yJulian/gate-link/pcb/GateLinkMaster.kicad_sch

## KiCad design pcb/GateLinkMaster.kicad_sch (2026-10-08)

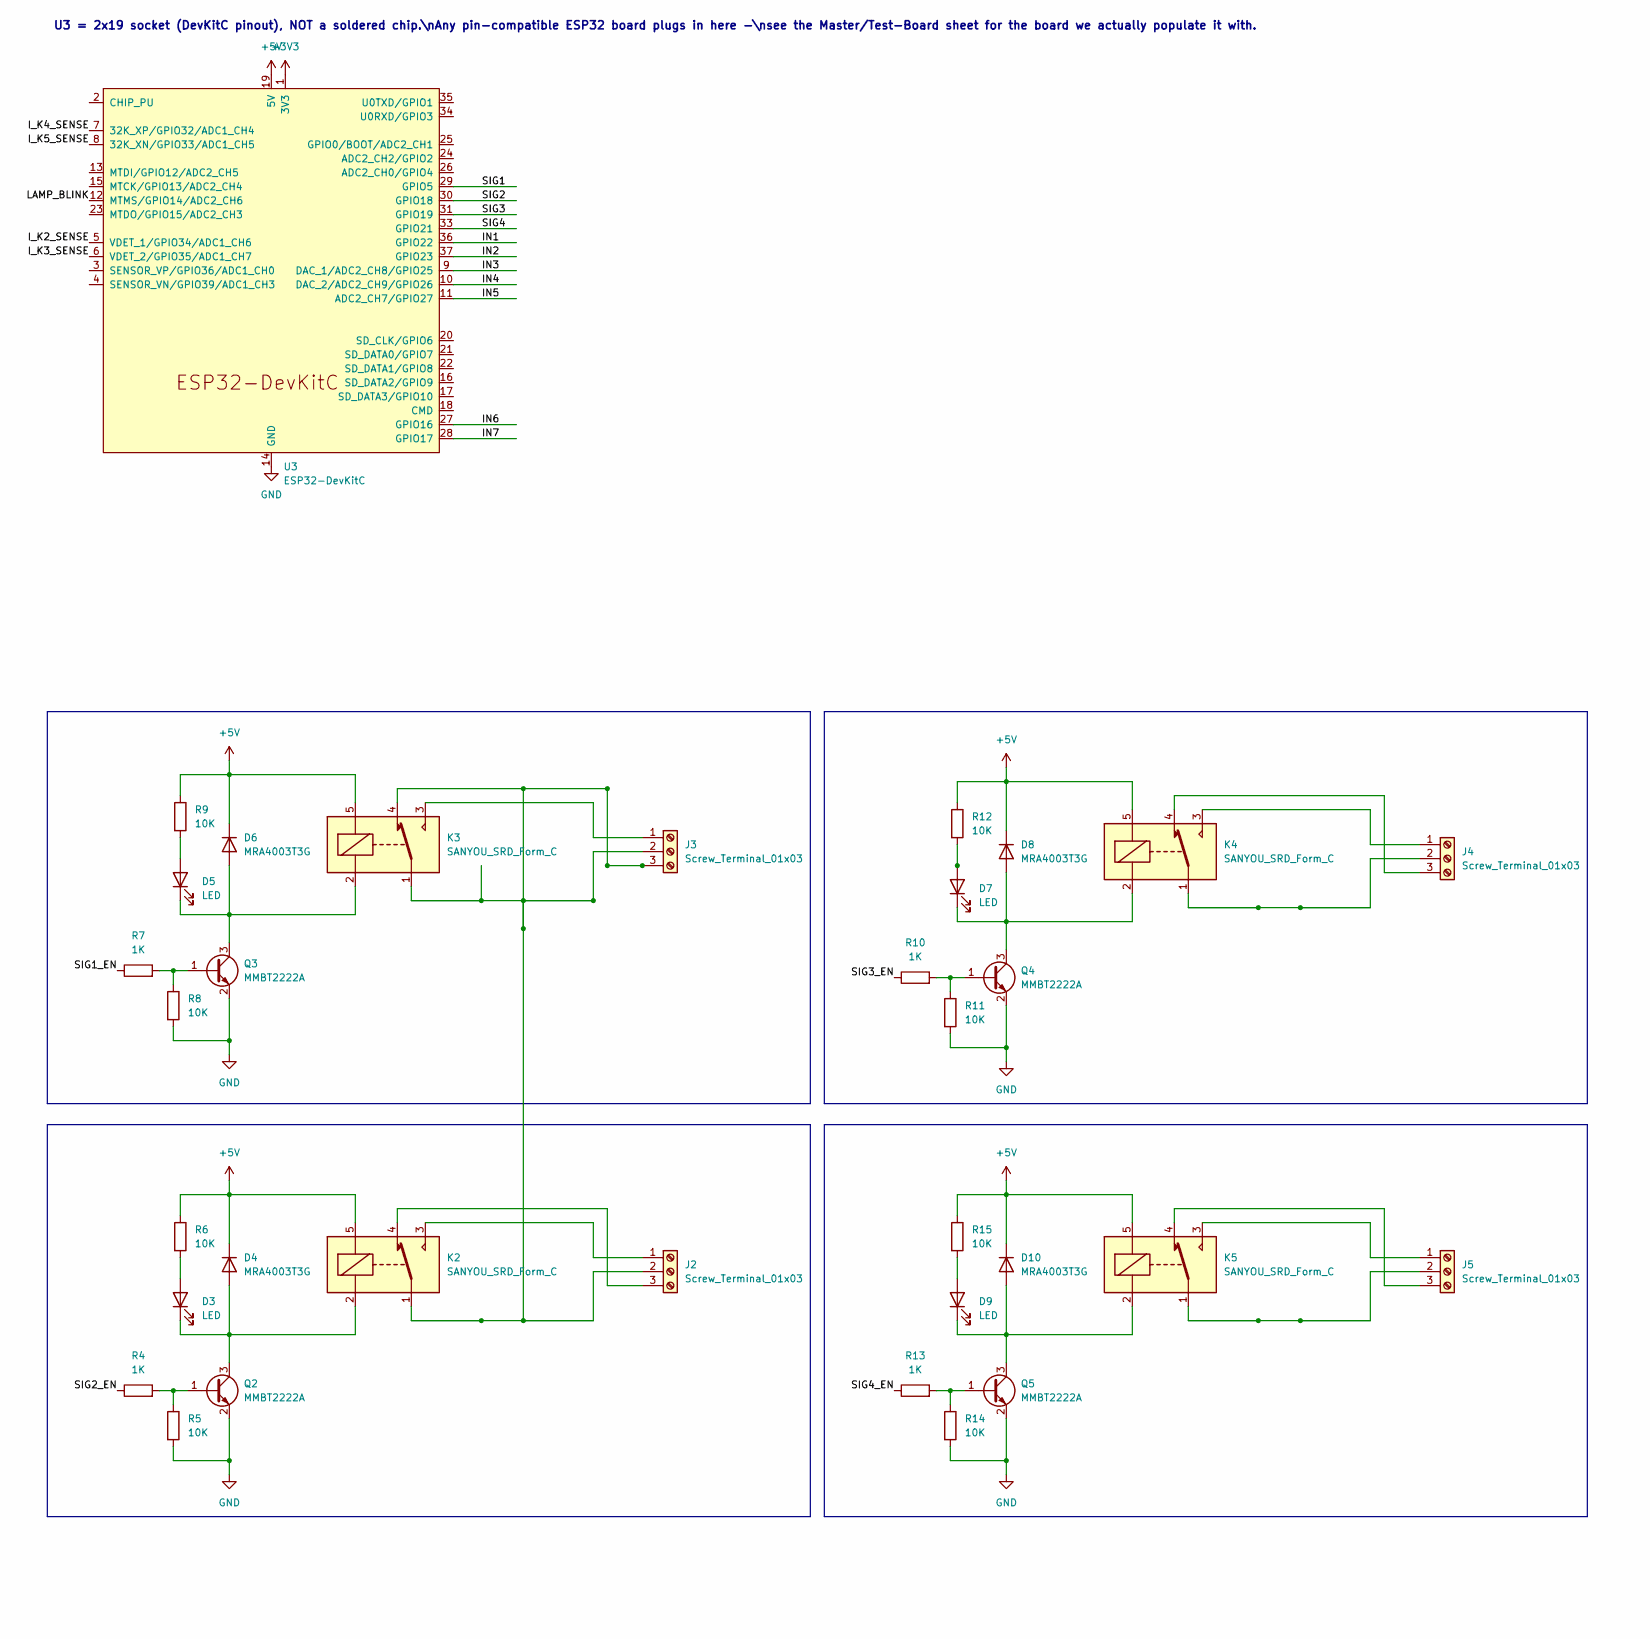
[picture p1: schematic GateLinkMaster.kicad_sch, part in row 1, column 1]

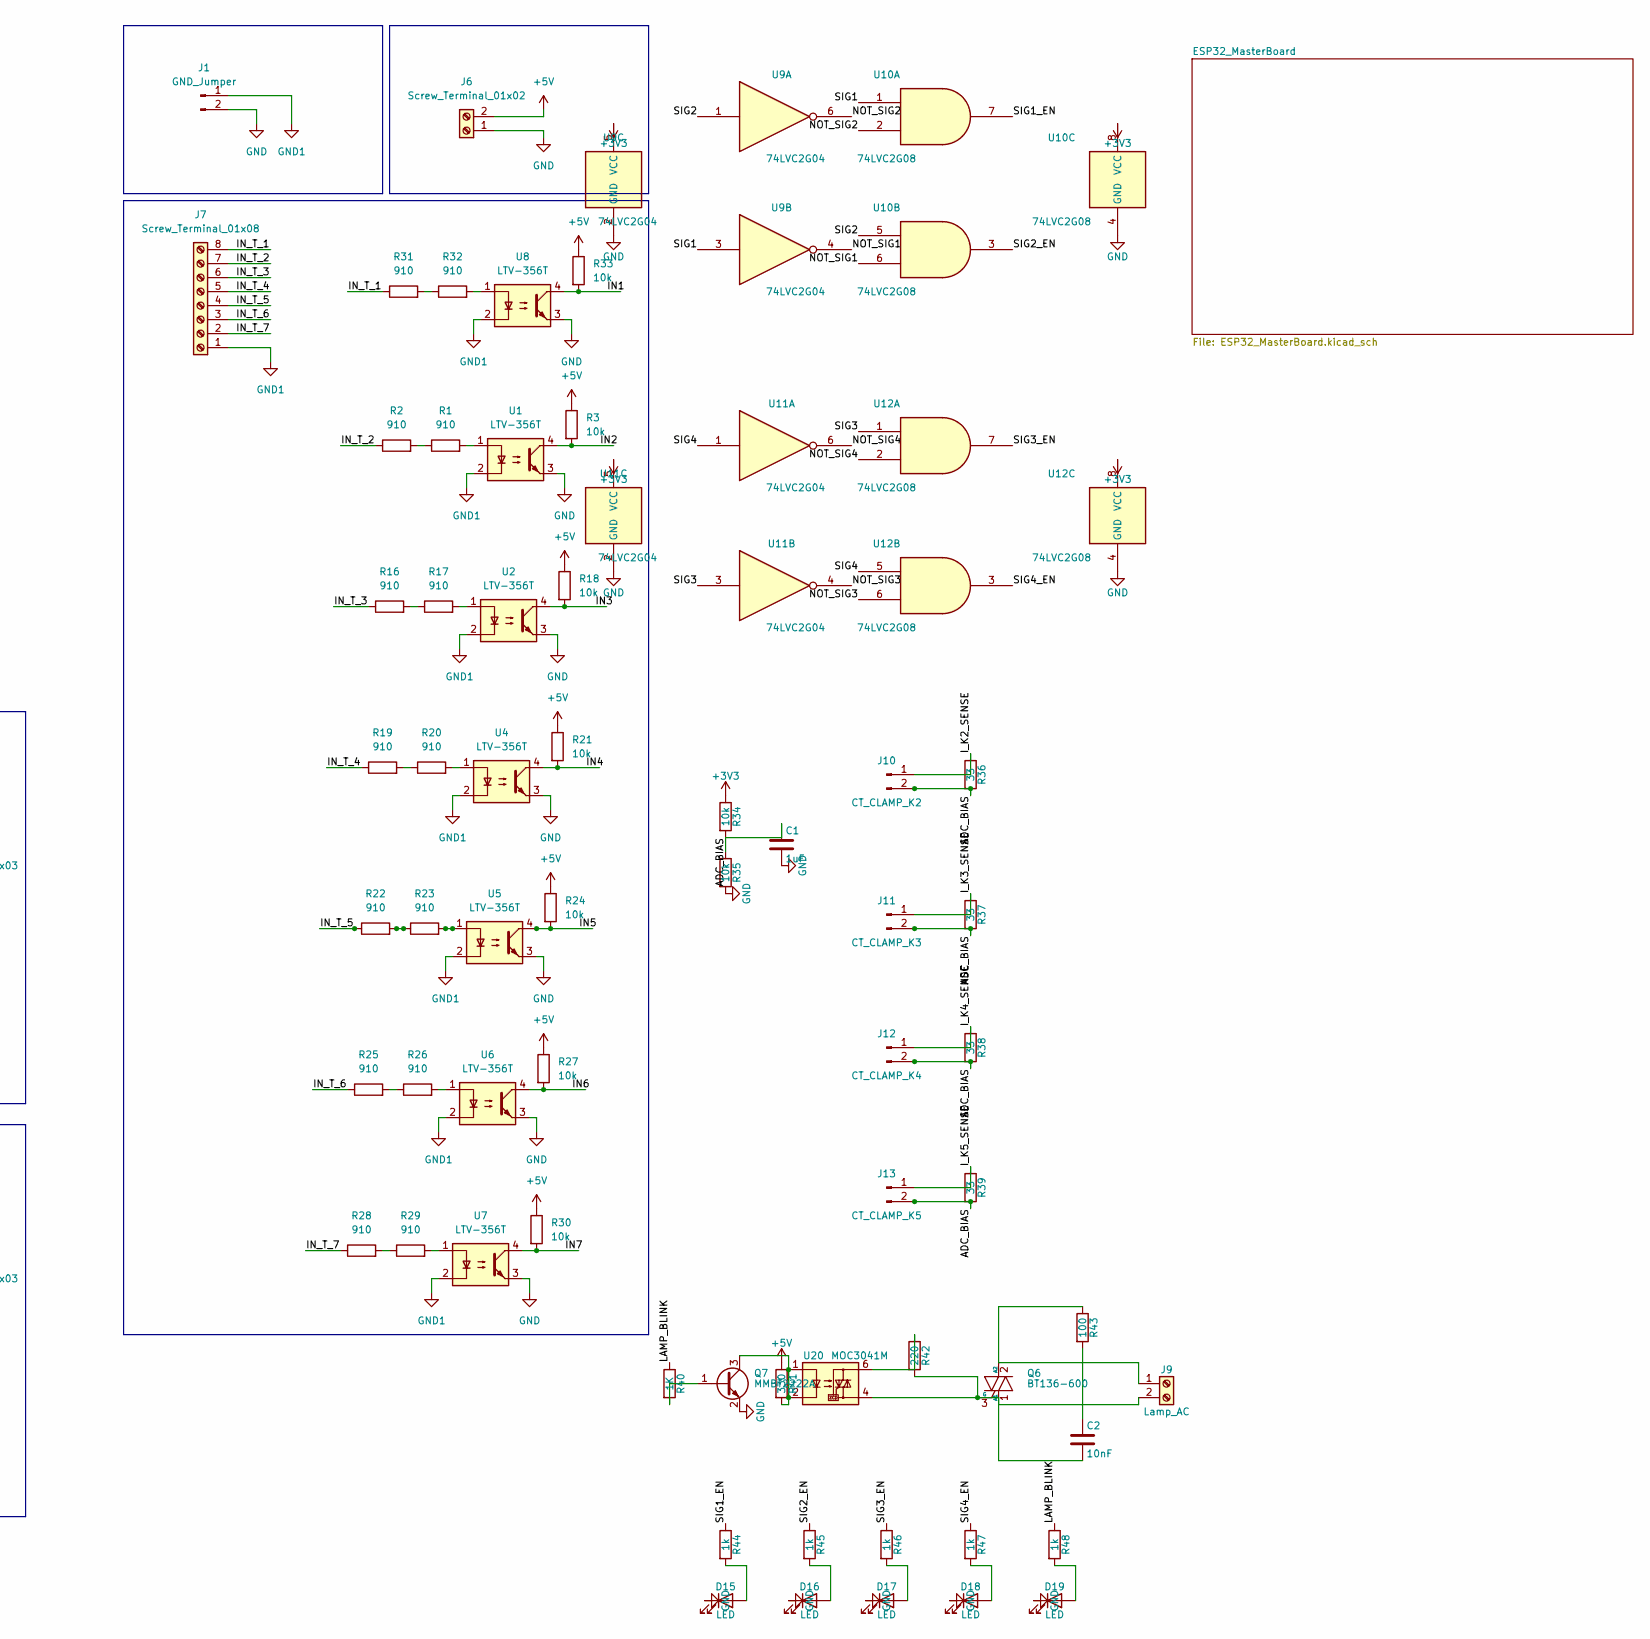
[picture p2: schematic GateLinkMaster.kicad_sch, part in row 1, column 2]

Parts:
C1: 1uF; C_0603_1608Metric
C2: 10nF; C_0603_1608Metric
D3, D5, D7, D9, D15, D16, D17, D18, D19: LED; LED_0603_1608Metric
D4, D6, D8, D10: MRA4003T3G; D_SMA
J1: GND_Jumper; PinHeader_1x02_P2.54mm_Vertical
J2, J3, J4, J5: Screw_Terminal_01x03; TerminalBlock_MaiXu_MX126-5.0-03P_1x03_P5.00mm
J6: Screw_Terminal_01x02; TerminalBlock_MaiXu_MX126-5.0-02P_1x02_P5.00mm
J7: Screw_Terminal_01x08; TerminalBlock_WAGO_236-108_1x08_P5.00mm_45Degree
J9: Lamp_AC; TerminalBlock_MaiXu_MX126-5.0-02P_1x02_P5.00mm
J10: CT_CLAMP_K2; PinHeader_1x02_P2.54mm_Vertical
J11: CT_CLAMP_K3; PinHeader_1x02_P2.54mm_Vertical
J12: CT_CLAMP_K4; PinHeader_1x02_P2.54mm_Vertical
J13: CT_CLAMP_K5; PinHeader_1x02_P2.54mm_Vertical
K2, K3, K4, K5: SANYOU_SRD_Form_C; Relay_SPDT_SANYOU_SRD_Series_Form_C
Q2, Q3, Q4, Q5, Q7: MMBT2222A; SOT-23
Q6: BT136-600; TO-220-3_Vertical
R1, R2, R16, R17, R19, R20, R22, R23, R25, R26, R28, R29, R31, R32: 910; R_0805_2012Metric
R3, R18, R21, R24, R27, R30, R33: 10k; R_0805_2012Metric
R4, R7, R10, R13, R40: 1K; R_0603_1608Metric
R5, R6, R8, R9, R11, R12, R14, R15: 10K; R_0603_1608Metric
R34, R35: 10k; R_0603_1608Metric
R36, R37, R38, R39: 33; R_0603_1608Metric
R41: 330; R_0603_1608Metric
R42: 220; R_0603_1608Metric
R43: 100; R_0805_2012Metric
R44, R45, R46, R47, R48: 1k; R_0603_1608Metric
U1, U2, U4, U5, U6, U7, U8: LTV-356T; SO-4_4.4x3.6mm_P2.54mm
U3: ESP32-DevKitC; ESP32-DevKitC-Local
U9, U11: 74LVC2G04; SOT-23-6
U10, U12: 74LVC2G08; SOT-23-8
U20: MOC3041M; DIP-6_W7.62mm

Connections:
+3V3: R34.1, U3.1 (3V3), U9.5 (VCC), U10.8 (VCC), U11.5 (VCC), U12.8 (VCC)
+5V: D4.1 (K), D6.1 (K), D8.1 (K), D10.1 (K), J6.2, K2.5, K3.5, K4.5, K5.5, R3.1, R6.1, R9.1, R12.1, R15.1, R18.1, R21.1, R24.1, R27.1, R30.1, R33.1, R41.1, U3.19 (5V)
ADC_BIAS: C1.1, J10.2, J11.2, J12.2, J13.2, R34.2, R35.1, R36.2, R37.2, R38.2, R39.2
GND: C1.2, D15.1 (K), D16.1 (K), D17.1 (K), D18.1 (K), D19.1 (K), J1.2, J6.1, Q2.2 (E), Q3.2 (E), Q4.2 (E), Q5.2 (E), Q7.2 (E), R5.2, R8.2, R11.2, R14.2, R35.2, U1.3, U2.3, U3.14 (GND), U3.32 (GND), U3.38 (GND), U4.3, U5.3, U6.3, U7.3, U8.3, U9.2 (GND), U10.4 (GND), U11.2 (GND), U12.4 (GND)
GND1: J1.1, J7.1, U1.2, U2.2, U4.2, U5.2, U6.2, U7.2, U8.2
IN1: R33.2, U3.36 (GPIO22), U8.4
IN2: R3.2, U1.4, U3.37 (GPIO23)
IN3: R18.2, U2.4, U3.9 (DAC_1/ADC2_CH8/GPIO25)
IN4: R21.2, U3.10 (DAC_2/ADC2_CH9/GPIO26), U4.4
IN5: R24.2, U3.11 (ADC2_CH7/GPIO27), U5.4
IN6: R27.2, U3.27 (GPIO16), U6.4
IN7: R30.2, U3.28 (GPIO17), U7.4
IN_T_1: J7.8, R31.1
IN_T_2: J7.7, R2.1
IN_T_3: J7.6, R16.1
IN_T_4: J7.5, R19.1
IN_T_5: J7.4, R22.1
IN_T_6: J7.3, R25.1
IN_T_7: J7.2, R28.1
I_K2_SENSE: J10.1, R36.1, U3.5 (VDET_1/GPIO34/ADC1_CH6)
I_K3_SENSE: J11.1, R37.1, U3.6 (VDET_2/GPIO35/ADC1_CH7)
I_K4_SENSE: J12.1, R38.1, U3.7 (32K_XP/GPIO32/ADC1_CH4)
I_K5_SENSE: J13.1, R39.1, U3.8 (32K_XN/GPIO33/ADC1_CH5)
LAMP_BLINK: R40.1, R48.1, U3.12 (MTMS/GPIO14/ADC2_CH6)
NOT_SIG1: U9.4, U10.6
NOT_SIG2: U9.6, U10.2
NOT_SIG3: U11.4, U12.6
NOT_SIG4: U11.6, U12.2
unnamed: C2.1, R43.2
unnamed: C2.2, J9.2, Q6.1 (A1), Q6.3 (G), R42.2, U20.4
unnamed: D3.1 (K), D4.2 (A), K2.2, Q2.3 (C)
unnamed: D3.2 (A), R6.2
unnamed: D5.1 (K), D6.2 (A), K3.2, Q3.3 (C)
unnamed: D5.2 (A), R9.2
unnamed: D7.1 (K), D8.2 (A), K4.2, Q4.3 (C)
unnamed: D7.2 (A), R12.2
unnamed: D9.2 (A), R15.2
unnamed: D9.1 (K), D10.2 (A), K5.2, Q5.3 (C)
unnamed: D15.2 (A), R44.2
unnamed: D16.2 (A), R45.2
unnamed: D17.2 (A), R46.2
unnamed: D18.2 (A), R47.2
unnamed: D19.2 (A), R48.2
unnamed: J2.1, K2.3
unnamed: J2.2, J3.2, J3.3, K2.1, K3.1, K3.4
unnamed: J2.3, K2.4
unnamed: J3.1, K3.3
unnamed: J4.1, K4.3
unnamed: J4.2, K4.1
unnamed: J4.3, K4.4
unnamed: J5.1, K5.3
unnamed: J5.2, K5.1
unnamed: J5.3, K5.4
unnamed: J9.1, Q6.2 (A2), R43.1
unnamed: Q2.1 (B), R4.2, R5.1
unnamed: Q3.1 (B), R7.2, R8.1
unnamed: Q4.1 (B), R10.2, R11.1
unnamed: Q5.1 (B), R13.2, R14.1
unnamed: Q7.1 (B), R40.2
unnamed: Q7.3 (C), R41.2, U20.1, U20.2
unnamed: R1.1, R2.2
unnamed: R1.2, U1.1
unnamed: R16.2, R17.1
unnamed: R17.2, U2.1
unnamed: R19.2, R20.1
unnamed: R20.2, U4.1
unnamed: R22.2, R23.1
unnamed: R23.2, U5.1
unnamed: R25.2, R26.1
unnamed: R26.2, U6.1
unnamed: R28.2, R29.1
unnamed: R29.2, U7.1
unnamed: R31.2, R32.1
unnamed: R32.2, U8.1
unnamed: R42.1, U20.6
SIG1: U3.29 (GPIO5), U9.3, U10.1
SIG1_EN: R7.1, R44.1, U10.7
SIG2: U3.30 (GPIO18), U9.1, U10.5
SIG2_EN: R4.1, R45.1, U10.3
SIG3: U3.31 (GPIO19), U11.3, U12.1
SIG3_EN: R10.1, R46.1, U12.7
SIG4: U3.33 (GPIO21), U11.1, U12.5
SIG4_EN: R13.1, R47.1, U12.3

Notes on the sheet:
U3 = 2x19 socket (DevKitC pinout), NOT a soldered chip.\nAny pin-compatible ESP32 board plugs in here -\nsee the Master/Test-Board sheet for the board we actually populate it with.
