yJulian/gate-link/src/physical/inputs.rs

//! Generic GPIO input watchers wired to `crate::physical::gate`.
//!
//! Two shapes cover every physical input this device has:
//! - [`edge_task`]: active-low, debounced, fires `action` once per press.
//!   Used for the local push button, the radio remote, the wind guard pulse,
//!   its reset input and the light barrier bypass input - they're all
//!   "something happened, react once".
//! - [`level_task`]: active-low, no debounce delay, calls `setter` on every
//!   level change. Used for the two light barriers, which need to be tracked
//!   continuously (broken/clear) rather than just on the initial edge.

use embassy_time::{Duration, Timer};
use esp_hal::gpio::Input;
use gate_core::Debouncer;

const EDGE_POLL_INTERVAL: Duration = Duration::from_millis(10);
/// Consecutive identical samples needed to accept a press or a release
/// (5 x 10ms = 50ms), so short spikes on long cables - e.g. induced by the
/// motors switching - don't count as a press.
const EDGE_STABLE_SAMPLES: u8 = 5;
const LEVEL_POLL_INTERVAL: Duration = Duration::from_millis(20);

#[embassy_executor::task(pool_size = 5)]
pub async fn edge_task(pin: Input<'static>, action: fn()) -> ! {
    let mut debouncer = Debouncer::new(EDGE_STABLE_SAMPLES);
    loop {
        if debouncer.sample(pin.is_low()) {
            action();
        }
        Timer::after(EDGE_POLL_INTERVAL).await;
    }
}

#[embassy_executor::task(pool_size = 2)]
pub async fn level_task(pin: Input<'static>, setter: fn(bool)) -> ! {
    let mut last_active = pin.is_low();
    setter(last_active);
    loop {
        let active = pin.is_low();
        if active != last_active {
            setter(active);
            last_active = active;
        }
        Timer::after(LEVEL_POLL_INTERVAL).await;
    }
}
