yJulian/gate-link/(commit log)

2026-07-05 Initial Begin
    [partitions.csv]
2026-07-06 Pysical Motor
2026-07-06 Add Motor control
2026-07-24 Rework gate control with wind lock, light barriers and position persistence
    Replace the single-button task with generic physical::inputs edge/level
    watchers driving open/close/stop/impulse plus the wind-guard and both
    light-barrier inputs. gate.rs now coordinates both leaf motors so they
    arrive together, tracks position via elapsed-time estimation, and
    persists position/wind-lock state to flash after every command settles.
    Also fixes the build: renames GateCommand's variants (clippy
    upper_case_acronyms was failing CI's -D warnings), and drops the unused
    BLE/trouble-host scaffold and esp-radio's ble/coex features, which were
    tripping an upstream esp-wifi-sys library link-order bug that broke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
    [gate.rs, inputs.rs, lib.rs, main.rs, motor.rs]
2026-07-24 Add CLAUDE.md/README.md and stop tracking .idea/
    Document the architecture for Claude Code and add a human-facing README
    (wiring, build, provisioning, HA entities). .idea/ is IDE-local project
    state that doesn't need to live in the repo.
2026-08-08 Update Name, Add pcb design
2026-08-08 Fix pcb directory being tracked as a broken gitlink
    pcb was previously its own git repo; after removing its nested .git
    directory, the outer repo still carried a mode-160000 gitlink entry
    pointing at that repo's last commit, with no .gitmodules to resolve
    it. GitHub rendered this as an empty/broken submodule and the actual
    KiCad project files were never committed. Re-add pcb as regular
    tracked files.
    [GateLinkMaster.kicad_pcb, GateLinkMaster.kicad_sch]
2026-08-08 Add README for pcb folder
2026-08-10 Rewire GPIO pins to match GateLinkMaster PCB schematic
    Motors, buttons, sensors and light barriers were on placeholder pins;
    remap to the actual net assignments on the board (GPIO5/18/19/21 for
    the two motor relays, GPIO22/23/25/26/27/16 for the button/sensor/
    barrier inputs). The one spare input (GPIO17) has no gate behavior on
    this board revision, so it's now just mirrored 1:1 to MQTT via a new
    spare_input_task and binary_sensor discovery entry.
2026-08-10 Update PCB Layout
    [GateLinkMaster.kicad_pcb, GateLinkMaster.kicad_sch]
2026-08-11 PCB Design
    [GateLinkMaster.kicad_pcb]
2026-10-08 Update Schematic
    [GateLinkMaster.kicad_pcb, GateLinkMaster.kicad_sch]
2026-10-12 Configurable leaf delays, offline-safe local control, host tests
    - Per-leaf open/close initial delays and run times in gate_config.rs
    - Gate logic moved to gate-core crate with host unit tests (cargo test-core)
    - Local control no longer depends on Wi-Fi/MQTT; Wi-Fi reconnects
    - Fix MQTT keep-alive and busy loop on broker disconnect
    - Reverse pause, proper debounce, relay outputs low at boot
    - Move leaf A open relay from GPIO5 (strapping pin) to GPIO4
2026-10-15 Switch to ESP32-S3
2026-10-15 Update README to current English entity names and pinout
